petschekr/rp2040-canbus/hardware/ioniq-v2-board.pdf

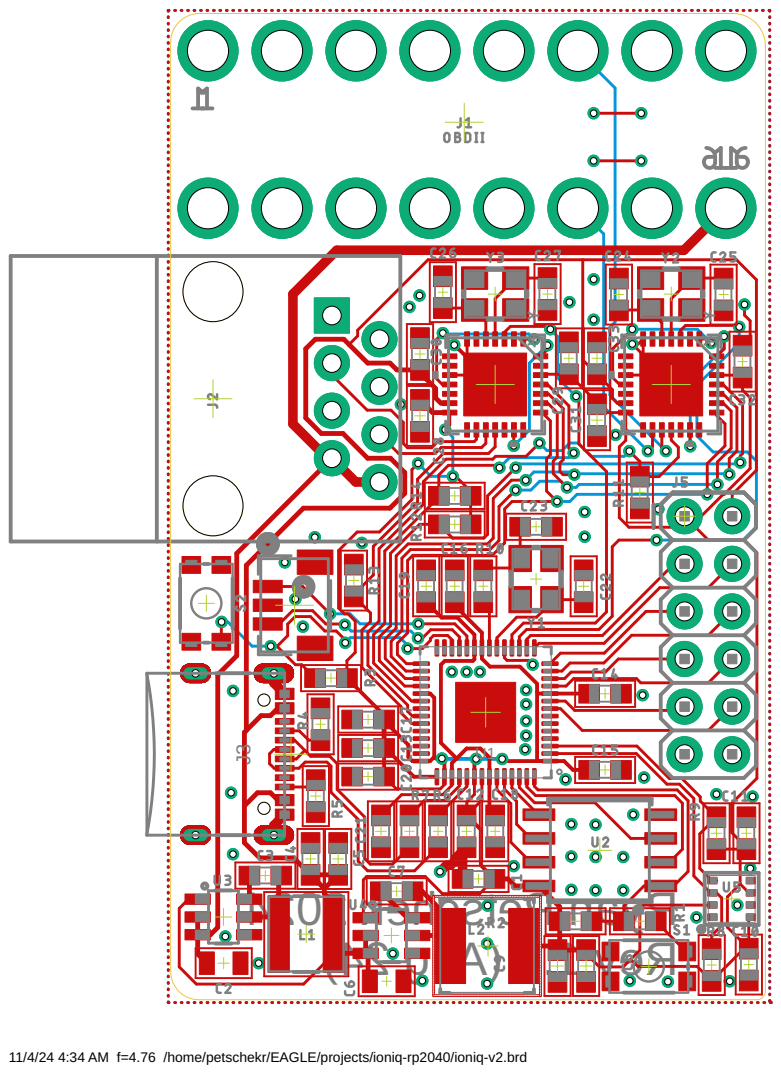
[picture p1: page 1]

11/4/24 4:34 AM f=4.76 /home/petschekr/EAGLE/projects/ioniq-rp2040/ioniq-v2.brd
