petschekr/rp2040-canbus/hardware/ioniq-v2-components.pdf

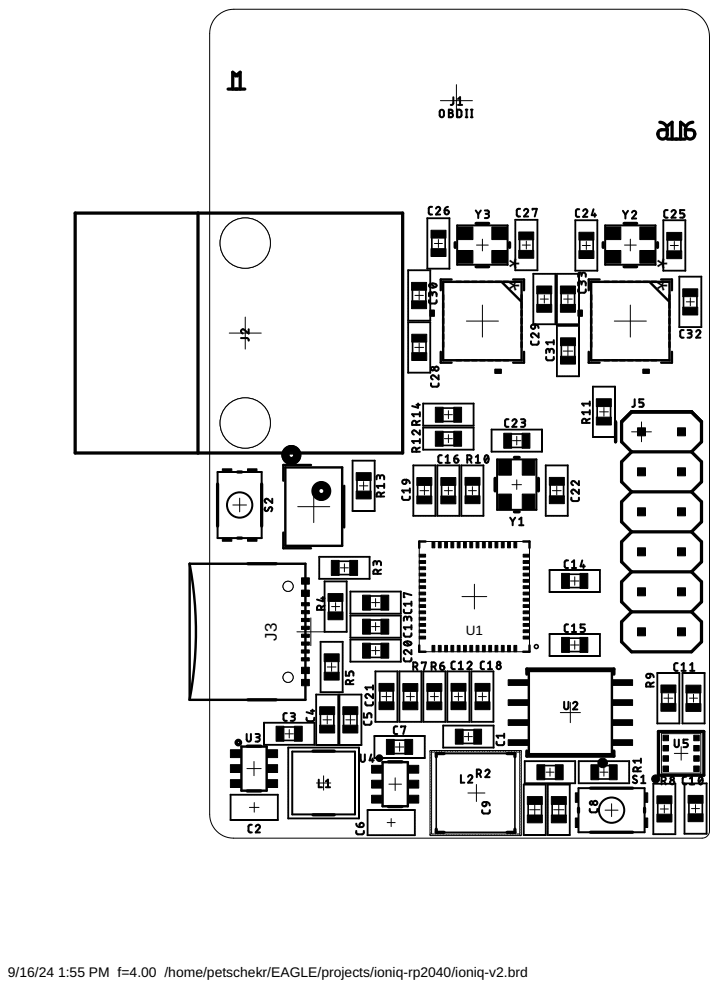
[picture p2: page 1]

9/16/24 1:55 PM f=4.00 /home/petschekr/EAGLE/projects/ioniq-rp2040/ioniq-v2.brd
