petschekr/rp2040-canbus/hardware/ioniq-v2-schematic.pdf

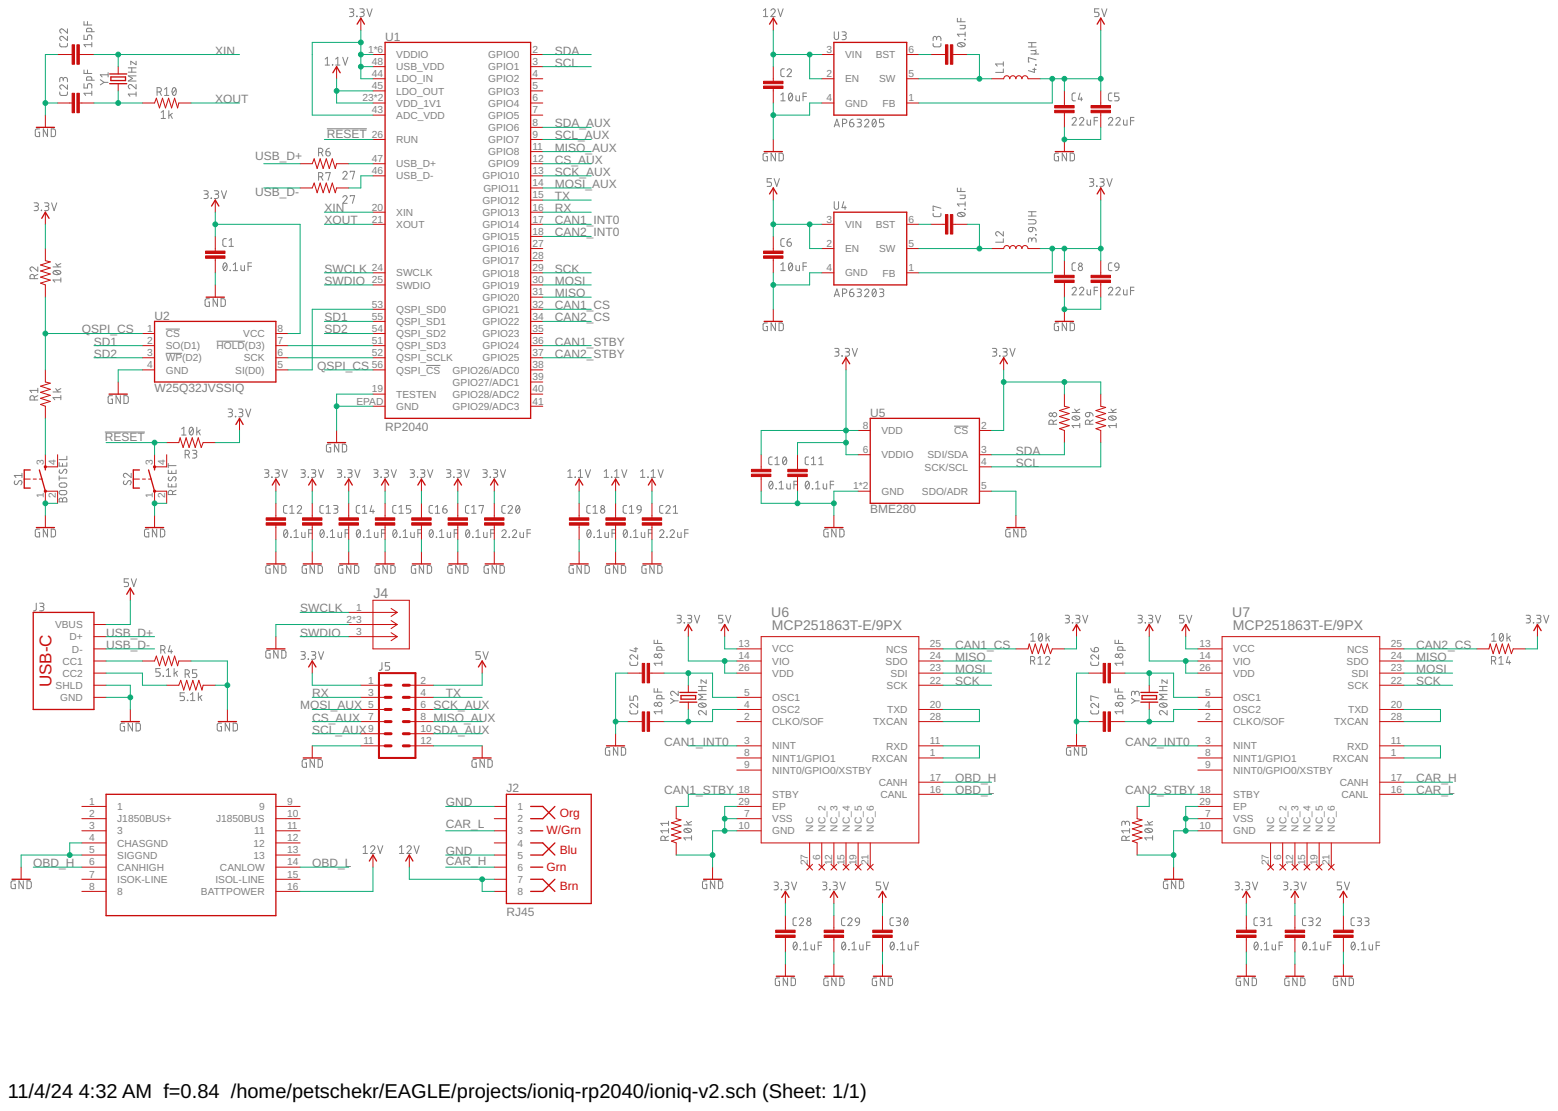
[picture p3: page 1]

11/4/24 4:32 AM f=0.84 /home/petschekr/EAGLE/projects/ioniq-rp2040/ioniq-v2.sch (Sheet: 1/1)
