petschekr/rp2040-canbus/hardware/ioniq-v2.brd

## EAGLE design hardware/ioniq-v2.brd (2024-11-04)

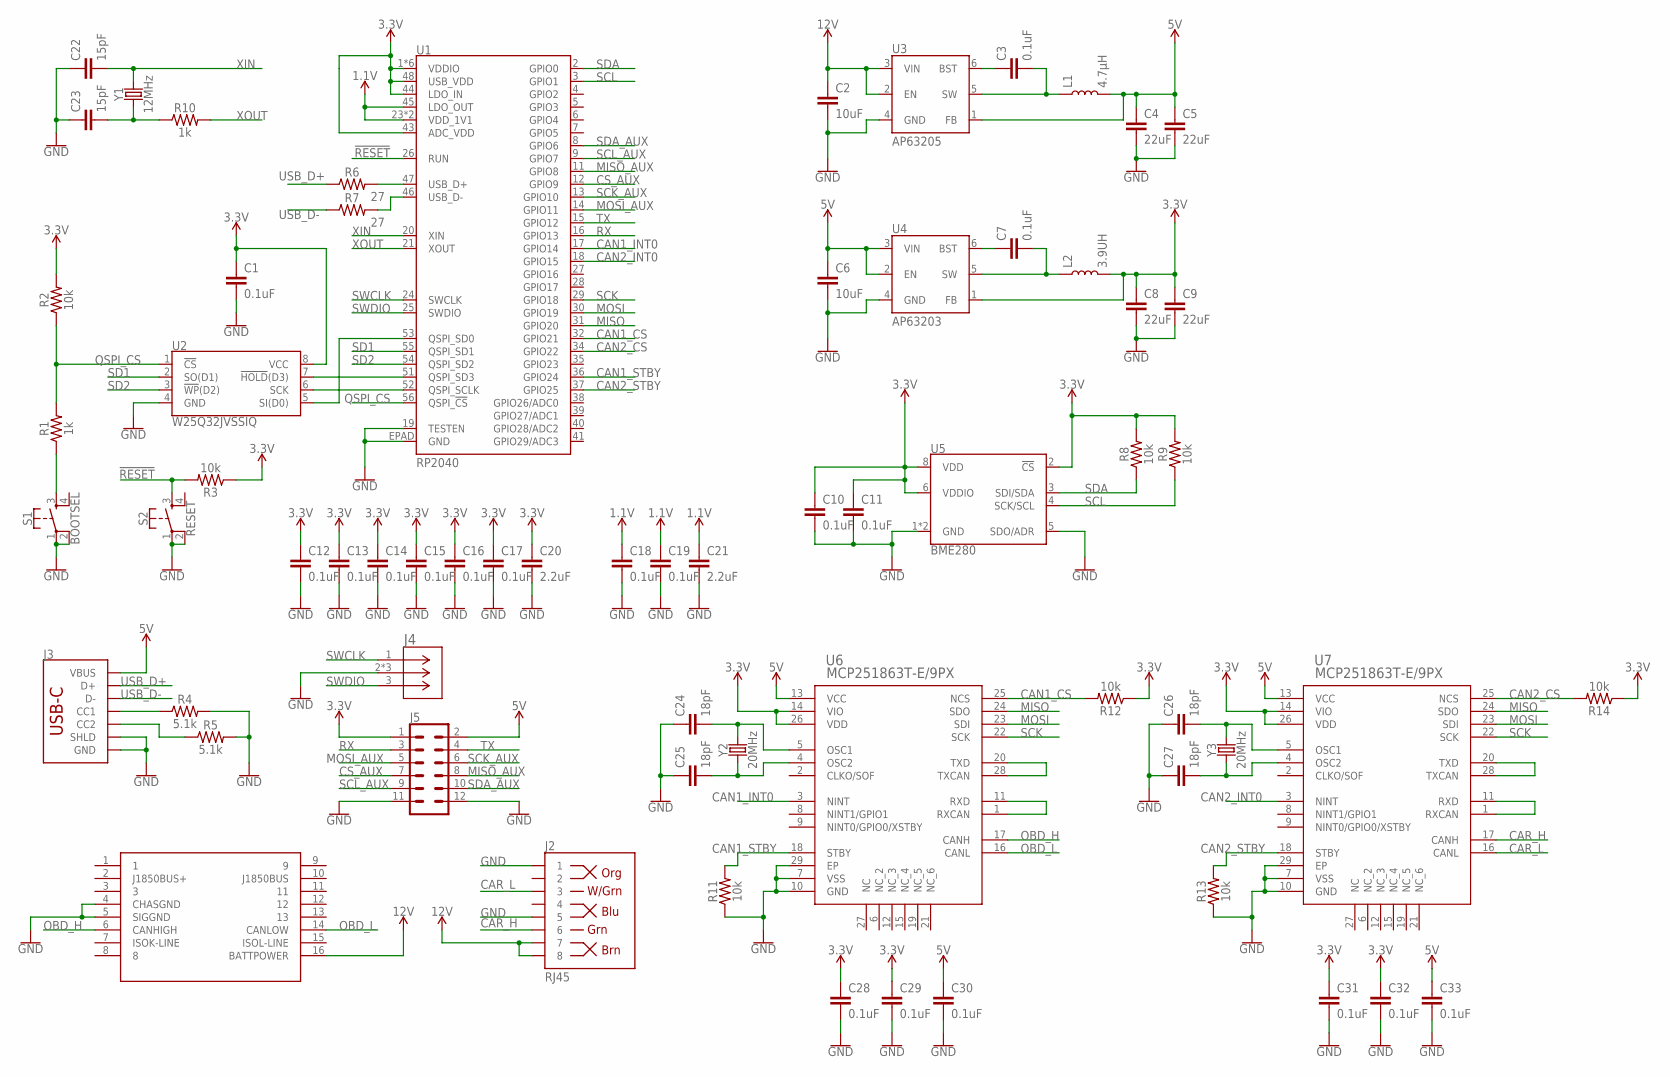
[picture p4: schematic ioniq-v2.sch]

Parts:
C1, C3, C7, C10, C11, C12, C13, C14, C15, C16, C17, C18, C19, C28, C29, C30, C31, C32, C33: 0.1uF; 0603
C2, C6: 10uF; 0805
C4, C5, C8, C9: 22uF; 0603
C20, C21: 2.2uF; 0603
C22, C23: 15pF; 0603
C24, C25, C26, C27: 18pF; 0603
J1: OBDII
J2: RJ45; RJ45-8
J3: USB_C_2-LAYER_PADS; USB-C-16P-2LAYER-PADS
J4: BM03B-SRSS-TB(LF)(SN); CONN_BM03B-SRSS-TB(LF)(SN)_JST
J5: 2X6 FEMALE; 2X6
L1: 4.7μH; INDUCTOR_4X4MM
L2: 3.9UH; INDUCTOR_3.9UH
R1, R10: 1k; 0603
R2, R3, R8, R9, R11, R12, R13, R14: 10k; 0603
R4, R5: 5.1k; 0603
R6, R7: 27; 0603
S1: BOOTSEL; TACTILE_SWITCH_SMD_4.6X2.8MM
S2: RESET; TACTILE_SWITCH_SMD_4.6X2.8MM
U1: RP2040; QFN-56
U2: W25Q32JVSSIQ; SOIC-8
U3: AP63205; SOT23-6
U4: AP63203; SOT23-6
U5: BME280; LGA-8-2.5X2.5
U6, U7: MCP251863T-E/9PX; VQFN28_9PX_3P25X3P25EPAD_MCH
Y1: 12MHz; CRYSTAL-SMD-3.2X2.5MM
Y2, Y3: 20MHz; CRYSTAL-SMD-3.2X2.5MM

Connections:
1.1V: C18.1, C19.1, C21.1, U1.23 (VDD_1V1), U1.45 (LDO_OUT), U1.50 (VDD_1V1)
3.3V: C1.1, C8.1, C9.1, C10.1, C11.1, C12.1, C13.1, C14.1, C15.1, C16.1, C17.1, C20.1, C28.1, C29.1, C31.1, C32.1, J5.1, L2.P$2 (2), R2.2, R3.1, R8.2, R9.2, R12.1, R14.1, U1.1 (VDDIO), U1.10 (VDDIO), U1.22 (VDDIO), U1.33 (VDDIO), U1.42 (VDDIO), U1.43 (ADC_VDD), U1.44 (LDO_IN), U1.48 (USB_VDD), U1.49 (VDDIO), U2.8 (VCC), U4.1 (FB), U5.2 (!CS), U5.6 (VDDIO), U5.8 (VDD), U6.14 (VIO), U6.26 (VDD), U7.14 (VIO), U7.26 (VDD)
5V: C4.1, C5.1, C6.1, C30.1, C33.1, J3.VBUS1 (VBUS), J3.VBUS2 (VBUS), J5.2, L1.P$2 (2), U3.1 (FB), U4.2 (EN), U4.3 (VIN), U6.13 (VCC), U7.13 (VCC)
12V: C2.1, J1.16 (BATTPOWER), J2.7, J2.8, U3.2 (EN), U3.3 (VIN)
!RESET: R3.2, S2.3, U1.26 (RUN)
CAN1_CS: R12.2, U1.32 (GPIO21), U6.25 (NCS)
CAN1_INT0: U1.17 (GPIO14), U6.3 (NINT)
CAN1_STBY: R11.2, U1.36 (GPIO24), U6.18 (STBY)
CAN2_CS: R14.2, U1.34 (GPIO22), U7.25 (NCS)
CAN2_INT0: U1.18 (GPIO15), U7.3 (NINT)
CAN2_STBY: R13.2, U1.37 (GPIO25), U7.18 (STBY)
CAR_H: J2.6, U7.17 (CANH)
CAR_L: J2.3, U7.16 (CANL)
CS_AUX: J5.7, U1.12 (GPIO9)
GND: C1.2, C2.2, C4.2, C5.2, C6.2, C8.2, C9.2, C10.2, C11.2, C12.2, C13.2, C14.2, C15.2, C16.2, C17.2, C18.2, C19.2, C20.2, C21.2, C22.1, C23.1, C24.1, C25.1, C26.1, C27.1, C28.2, C29.2, C30.2, C31.2, C32.2, C33.2, J1.4 (CHASGND), J1.5 (SIGGND), J2.1, J2.5, J3.GND, J3.GND2 (GND), J3.SHLD1 (SHLD), J3.SHLD2 (SHLD), J3.SHLD3 (SHLD), J3.SHLD4 (SHLD), J4.2, J4.4 (2), J4.5 (2), J5.11, J5.12, R4.2, R5.2, R11.1, R13.1, S1.1, S1.2, S2.1, S2.2, U1.19 (TESTEN), U1.EPAD (GND), U2.4 (GND), U3.4 (GND), U4.4 (GND), U5.1 (GND), U5.5 (SDO/ADR), U5.7 (GND), U6.7 (VSS), U6.10 (GND), U6.29 (EP), U7.7 (VSS), U7.10 (GND), U7.29 (EP)
MISO: U1.31 (GPIO20), U6.24 (SDO), U7.24 (SDO)
MISO_AUX: J5.8, U1.11 (GPIO8)
MOSI: U1.30 (GPIO19), U6.23 (SDI), U7.23 (SDI)
MOSI_AUX: J5.5, U1.14 (GPIO11)
unnamed: U1.52 (QSPI_SCLK), U2.6 (SCK)
unnamed: U1.51 (QSPI_SD3), U2.7 (!HOLD!(D3))
unnamed: U1.53 (QSPI_SD0), U2.5 (SI(D0))
unnamed: J3.A5 (CC1), R4.1
unnamed: C3.1, U3.6 (BST)
unnamed: C3.2, L1.P$1 (1), U3.5 (SW)
unnamed: J3.B5 (CC2), R5.1
unnamed: C7.1, U4.6 (BST)
unnamed: C7.2, L2.P$1 (1), U4.5 (SW)
unnamed: R7.2, U1.46 (USB_D-)
unnamed: R6.2, U1.47 (USB_D+)
unnamed: C23.2, R10.1, Y1.1
unnamed: R1.1, S1.3
unnamed: U6.20 (TXD), U6.28 (TXCAN)
unnamed: U6.1 (RXCAN), U6.11 (RXD)
unnamed: C24.2, U6.5 (OSC1), Y2.3 (2)
unnamed: C25.2, U6.4 (OSC2), Y2.1
unnamed: U7.1 (RXCAN), U7.11 (RXD)
unnamed: U7.20 (TXD), U7.28 (TXCAN)
unnamed: C26.2, U7.5 (OSC1), Y3.3 (2)
unnamed: C27.2, U7.4 (OSC2), Y3.1
OBD_H: J1.6 (CANHIGH), U6.17 (CANH)
OBD_L: J1.14 (CANLOW), U6.16 (CANL)
QSPI_CS: R1.2, R2.1, U1.56 (QSPI_!CS!), U2.1 (!CS!)
RX: J5.3, U1.16 (GPIO13)
SCK: U1.29 (GPIO18), U6.22 (SCK), U7.22 (SCK)
SCK_AUX: J5.6, U1.13 (GPIO10)
SCL: R9.1, U1.3 (GPIO1), U5.4 (SCK/SCL)
SCL_AUX: J5.9, U1.9 (GPIO7)
SD1: U1.55 (QSPI_SD1), U2.2 (SO(D1))
SD2: U1.54 (QSPI_SD2), U2.3 (!WP!(D2))
SDA: R8.1, U1.2 (GPIO0), U5.3 (SDI/SDA)
SDA_AUX: J5.10, U1.8 (GPIO6)
SWCLK: J4.1, U1.24 (SWCLK)
SWDIO: J4.3, U1.25 (SWDIO)
TX: J5.4, U1.15 (GPIO12)
USB_D+: J3.A6 (D+), J3.B6 (D+), R6.1
USB_D-: J3.A7 (D-), J3.B7 (D-), R7.1
XIN: C22.2, U1.20 (XIN), Y1.3 (2)
XOUT: R10.2, U1.21 (XOUT)

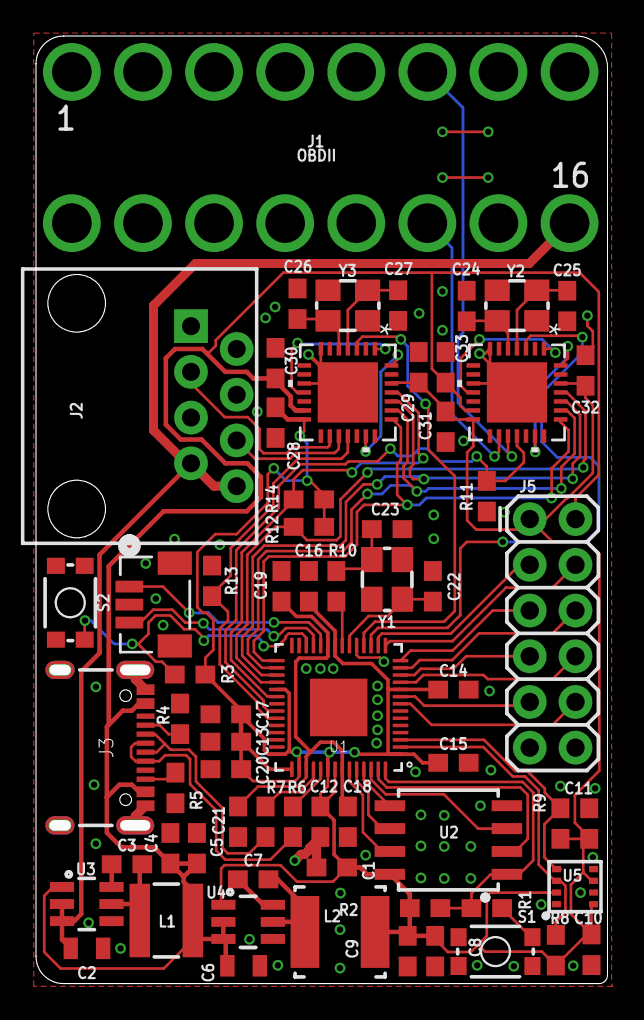
[picture p5: board ioniq-v2.brd from above]

Board: 2 copper layers, 31.8 x 52.6 mm, 66 parts (0 on the bottom side), 59 nets.
