petschekr/rp2040-canbus/(commit log)

2024-09-22 Working battery stats
2024-09-23 Tasks to demo forwarding battery info to the Comma RJ-45 port
2024-09-28 Improve ISO-TP logic to avoid deadlocks
    [main.rs]
2024-09-28 Implement ISO-TP timeout to prevent deadlocking
    [main.rs]
2024-10-16 Clear invalid transfers upon error
    [main.rs]
2024-11-04 Add hardware files
    [ioniq-v2.brd, ioniq-v2.sch]
2024-11-22 Compensate measured temperature and humidity to a calibrated reference
2026-07-17 Rename a couple of ECUs and simplify FIFO setup code
2026-07-21 Restrict transmission attempts and reset the TX FIFO when it fills due to bus errors
    [main.rs]
2026-07-29 Add additional debug info and fix weird response from cluster
    [main.rs]
2026-07-29 Fix OBD sender mutex being held across timer await point
    [main.rs]
2026-08-05 Add BDC door and brake status for MY2025
2026-08-05 Increase update rate to 2 Hz
